vaxdatex/DIY_Envelope/ENVPNL2_Montaza/ENVPNL2-layout.pdf

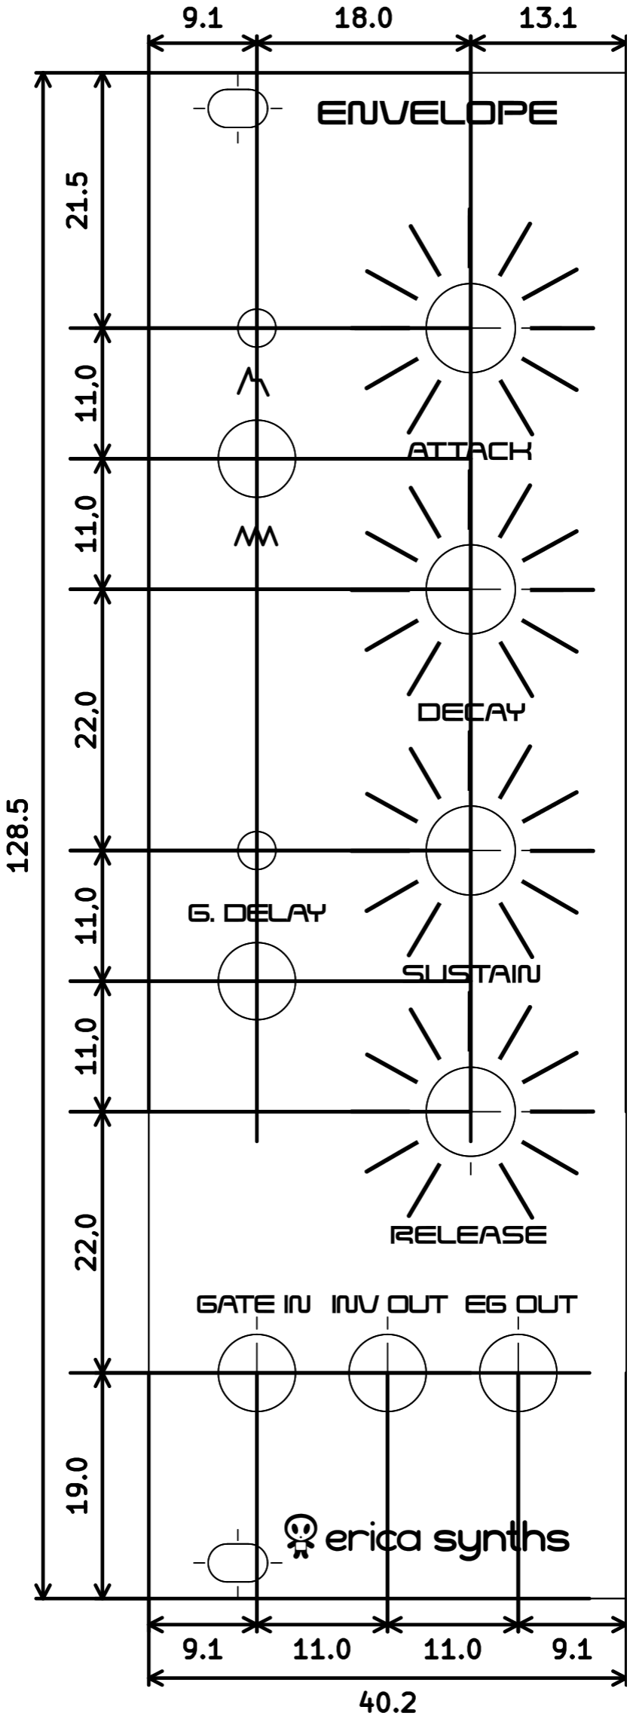
[picture p1: page 1]
