vaxdatex/DIY_Envelope/ENVPNL2_Montaza/ENVPNL2-layout_noDim.pdf

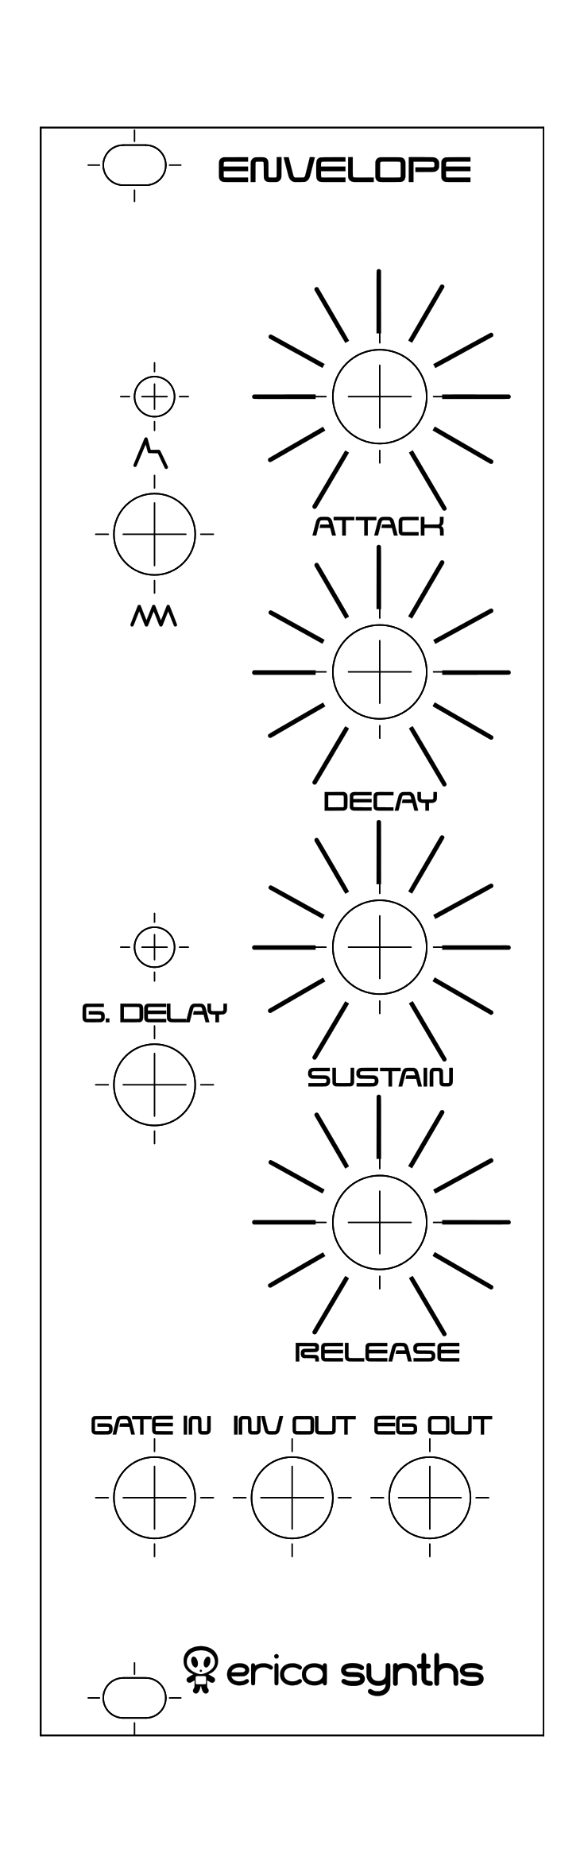
[picture p2: page 1]
